adafruit/Adafruit-DC-Stepper-Motor-FeatherWing-PCB/Adafruit DC+Stepper Wing.brd

## EAGLE design Adafruit DC+Stepper Wing.brd (2016-03-01)

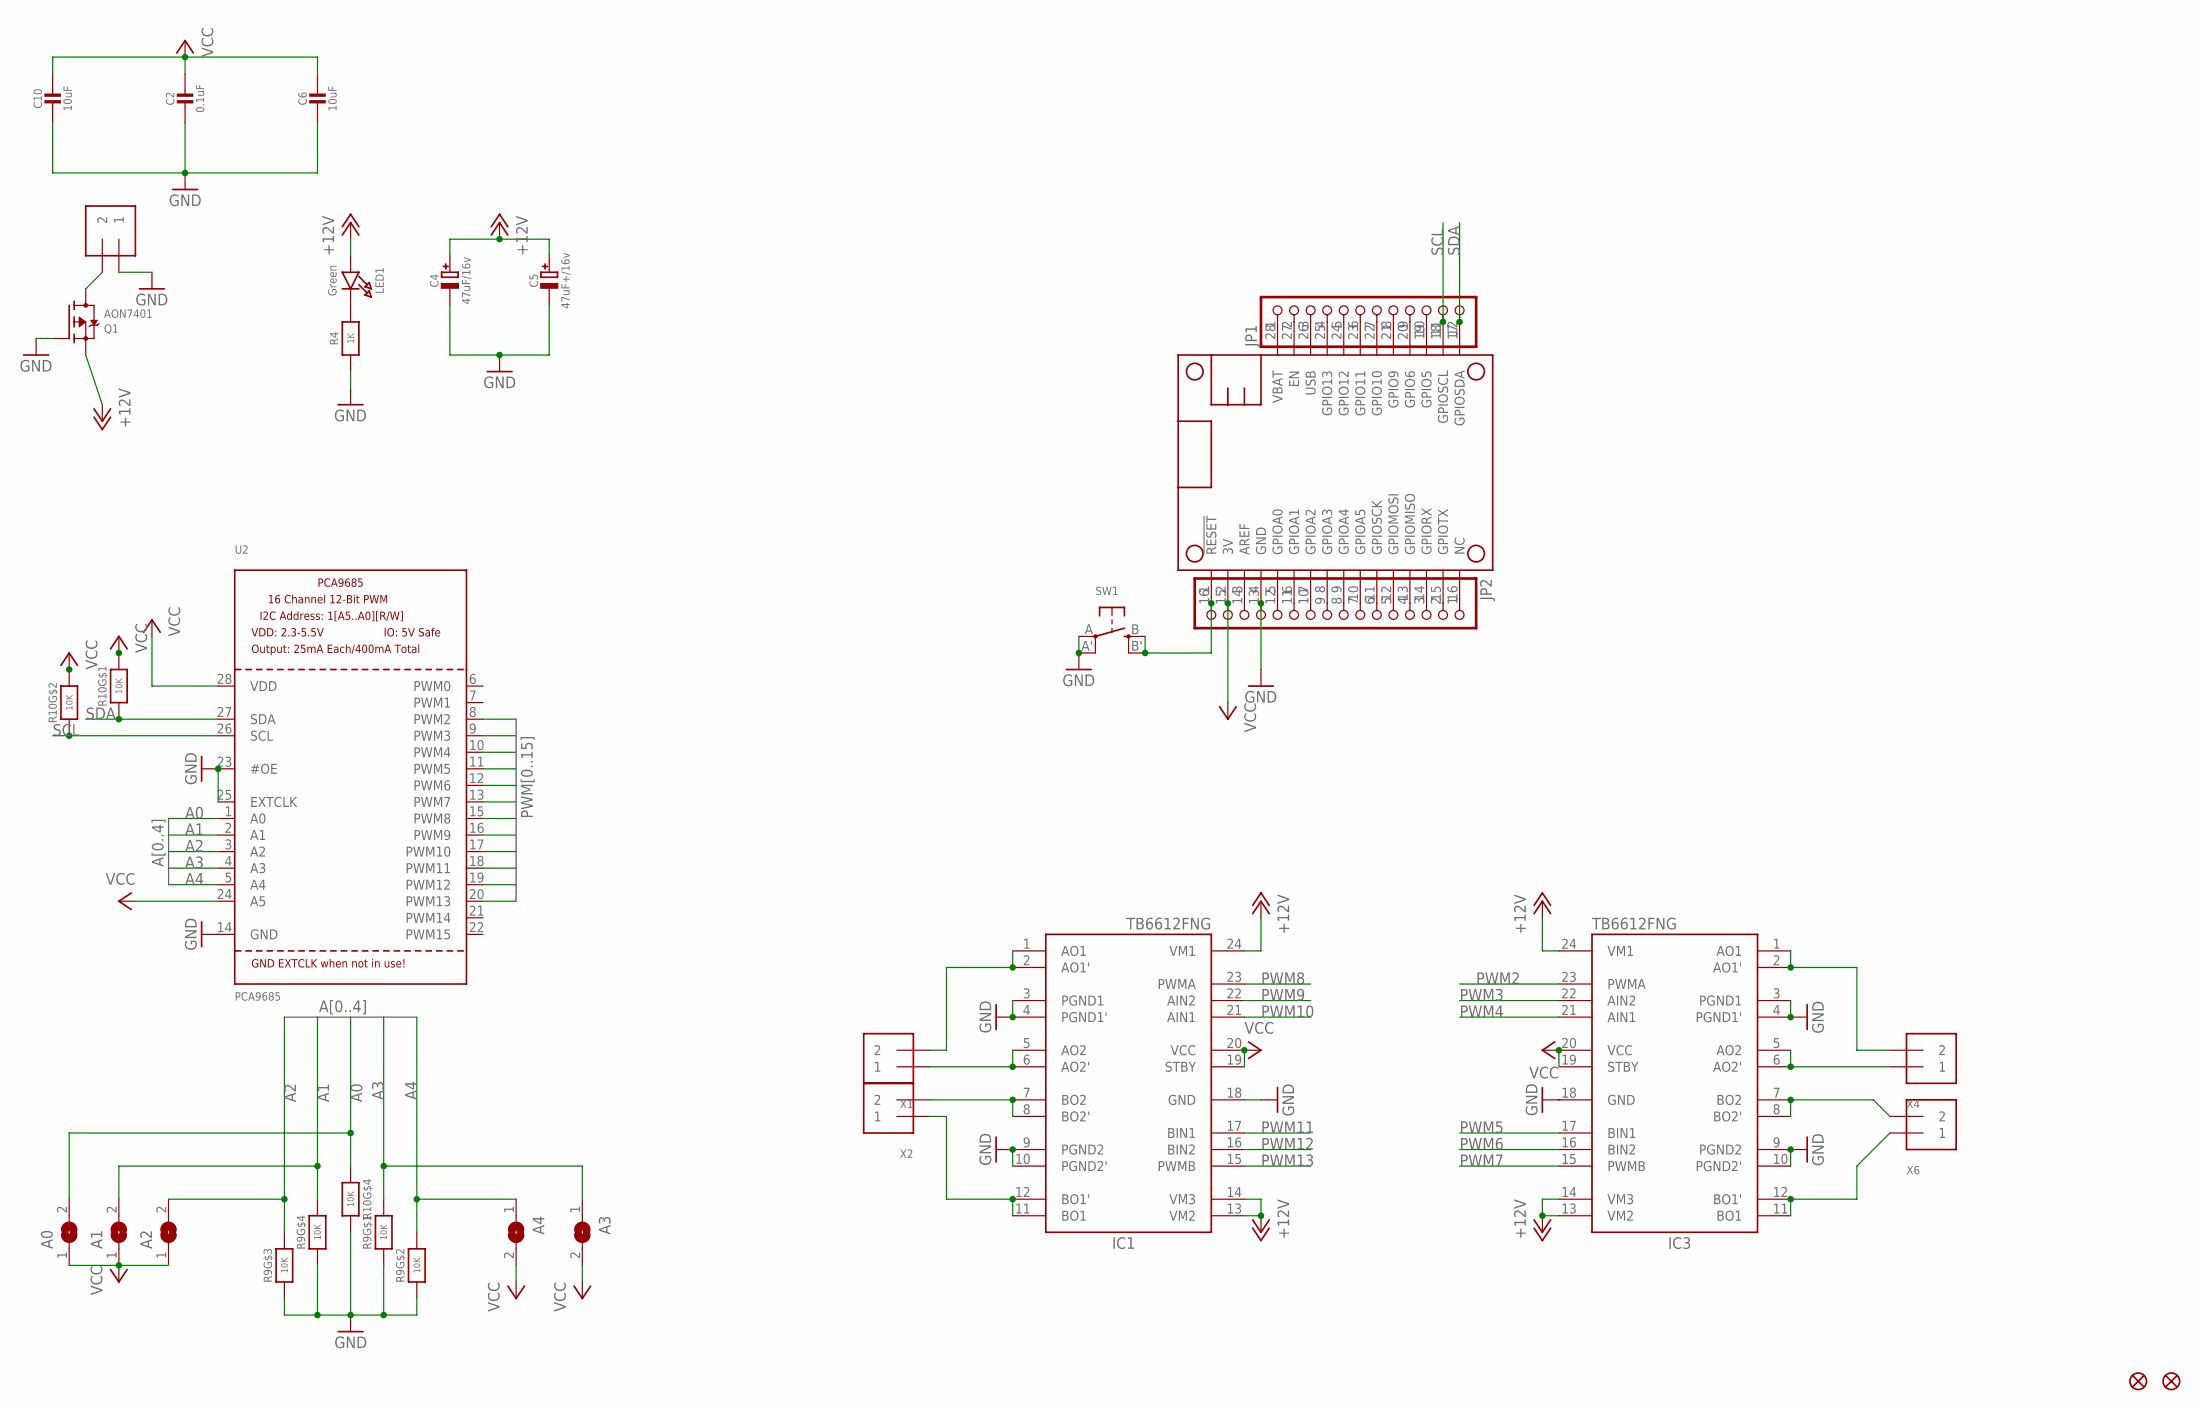
[picture p2: schematic Adafruit DC+Stepper Wing.sch]

Parts:
A0, A1, A2, A3, A4: SOLDERJUMPERREFLOW_NOPASTE; SOLDERJUMPER_REFLOW_NOPASTE
C2: 0.1uF; 0805-NO
C4: 47uF/16v; PANASONIC_C
C5: 47uF+/16v; PANASONIC_C
C6, C10: 10uF; 0805-NO
IC1, IC3: TB6612FNG; SSOP24
JP1: HEADER-1X12; 1X12_ROUND
JP2: HEADER-1X16ROUND; 1X16_ROUND
LED1: Green; CHIPLED_0805_NOOUTLINE
MPOWER: 1X2-3.5MM
MS1: FEATHERWING
Q1: AON7401; POWERDI3333
R4: 1K; 0805-NO
R9, R10: 10K; RESPACK_4X0603
SW1: SWITCH_TACT_SMT4.6X2.8; BTN_KMR2_4.6X2.8
U2: PCA9685; TSSOP28
U$3, U$4: FIDUCIAL""; FIDUCIAL_1MM
X1, X2, X4, X6: TERMBLOCK_1X2; TERMBLOCK_1X2-3.5MM

Connections:
+12V: C4.+, C5.+, IC1.13 (VM2), IC1.14 (VM3), IC1.24 (VM1), IC3.13 (VM2), IC3.14 (VM3), IC3.24 (VM1), LED1.A, Q1.1 (S), Q1.2 (S), Q1.3 (S)
A0: A0.2, R10.4 (1), U2.1 (A0)
A1: A1.2, R9.5 (2), U2.2 (A1)
A2: A2.2, R9.6 (2), U2.3 (A2)
A3: A3.1, R9.8 (2), U2.4 (A3)
A4: A4.1, R9.7 (2), U2.5 (A4)
GND: C2.2, C4.-, C5.-, C6.2, C10.2, IC1.3 (PGND1), IC1.4 (PGND1'), IC1.9 (PGND2), IC1.10 (PGND2'), IC1.18 (GND), IC3.3 (PGND1), IC3.4 (PGND1'), IC3.9 (PGND2), IC3.10 (PGND2'), IC3.18 (GND), JP2.13, MPOWER.1, MS1.4 (GND), Q1.4 (G), R4.1, R9.1, R9.2 (1), R9.3 (1), R9.4 (1), R10.5 (2), SW1.A, SW1.A' (P1), U2.14 (GND), U2.23 (#OE), U2.25 (EXTCLK)
unnamed: JP1.2, MS1.27 (EN)
unnamed: JP1.4, MS1.25 (GPIO13)
unnamed: MPOWER.2, Q1.5678 (D)
unnamed: IC1.1 (AO1), IC1.2 (AO1'), X1.2
unnamed: JP1.5, MS1.24 (GPIO12)
unnamed: IC1.5 (AO2), IC1.6 (AO2'), X1.1
unnamed: IC1.7 (BO2), IC1.8 (BO2'), X2.2
unnamed: JP1.6, MS1.23 (GPIO11)
unnamed: IC1.11 (BO1), IC1.12 (BO1'), X2.1
unnamed: JP1.7, MS1.22 (GPIO10)
unnamed: JP1.8, MS1.21 (GPIO9)
unnamed: IC3.1 (AO1), IC3.2 (AO1'), X4.2
unnamed: JP1.9, MS1.20 (GPIO6)
unnamed: IC3.5 (AO2), IC3.6 (AO2'), X4.1
unnamed: IC3.7 (BO2), IC3.8 (BO2'), X6.2
unnamed: JP1.10, MS1.19 (GPIO5)
unnamed: IC3.11 (BO1), IC3.12 (BO1'), X6.1
unnamed: JP2.1, MS1.16 (NC)
unnamed: JP2.2, MS1.15 (GPIOTX)
unnamed: JP2.3, MS1.14 (GPIORX)
unnamed: JP2.4, MS1.13 (GPIOMISO)
unnamed: JP2.5, MS1.12 (GPIOMOSI)
unnamed: JP2.6, MS1.11 (GPIOSCK)
unnamed: JP2.7, MS1.10 (GPIOA5)
unnamed: JP2.8, MS1.9 (GPIOA4)
unnamed: JP2.9, MS1.8 (GPIOA3)
unnamed: JP2.10, MS1.7 (GPIOA2)
unnamed: JP2.11, MS1.6 (GPIOA1)
unnamed: JP2.12, MS1.5 (GPIOA0)
unnamed: JP2.14, MS1.3 (AREF)
unnamed: JP2.16, MS1.1 (!RESET), SW1.B (S), SW1.B' (S1)
unnamed: LED1.C, R4.2
PWM2: IC3.23 (PWMA), U2.8 (PWM2)
PWM3: IC3.22 (AIN2), U2.9 (PWM3)
PWM4: IC3.21 (AIN1), U2.10 (PWM4)
PWM5: IC3.17 (BIN1), U2.11 (PWM5)
PWM6: IC3.16 (BIN2), U2.12 (PWM6)
PWM7: IC3.15 (PWMB), U2.13 (PWM7)
PWM8: IC1.23 (PWMA), U2.15 (PWM8)
PWM9: IC1.22 (AIN2), U2.16 (PWM9)
PWM10: IC1.21 (AIN1), U2.17 (PWM10)
PWM11: IC1.17 (BIN1), U2.18 (PWM11)
PWM12: IC1.16 (BIN2), U2.19 (PWM12)
PWM13: IC1.15 (PWMB), U2.20 (PWM13)
SCL: JP1.11, MS1.18 (GPIOSCL), R10.2 (1), U2.26 (SCL)
SDA: JP1.12, MS1.17 (GPIOSDA), R10.1, U2.27 (SDA)
USB: JP1.3, MS1.26 (USB)
VBAT: JP1.1, MS1.28 (VBAT)
VCC: A0.1, A1.1, A2.1, A3.2, A4.2, C2.1, C6.1, C10.1, IC1.19 (STBY), IC1.20 (VCC), IC3.19 (STBY), IC3.20 (VCC), JP2.15, MS1.2 (3V), R10.7 (2), R10.8 (2), U2.24 (A5), U2.28 (VDD)

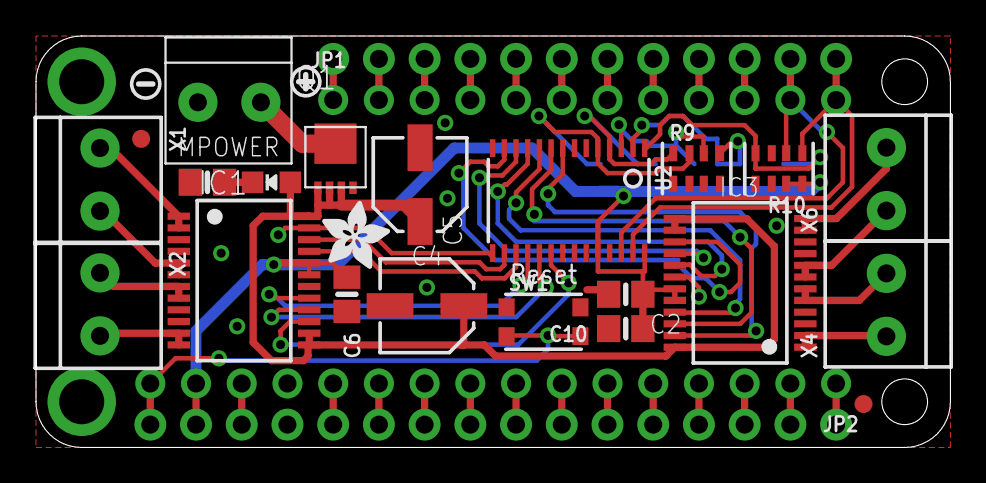
[picture p3: board Adafruit DC+Stepper Wing.brd from above]

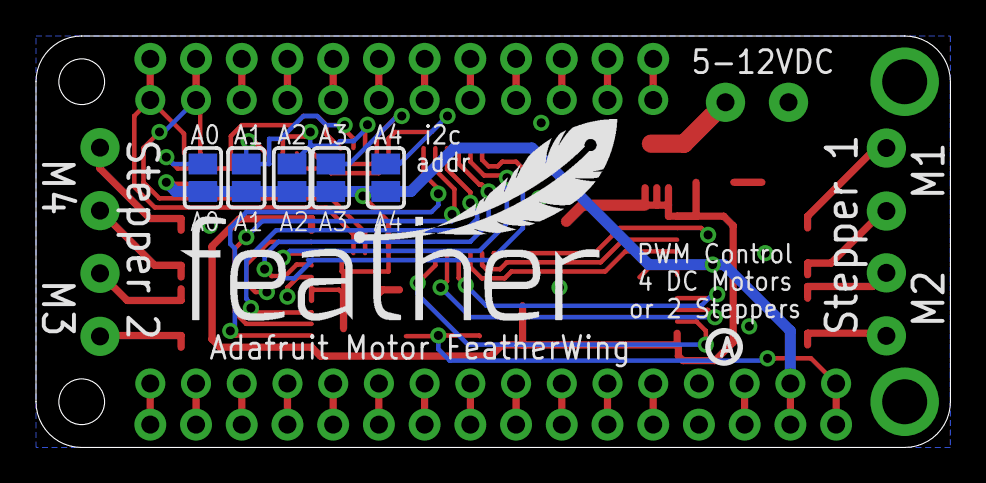
[picture p4: board Adafruit DC+Stepper Wing.brd from below]

Board: 2 copper layers, 50.8 x 22.9 mm, 34 parts (7 on the bottom side), 56 nets.

Other parts of the board:
U$1: SYMBOL_PLUS
U$2: SYMBOL_MINUS
U$5: ADAFRUIT_3.5MM
U$6: FEATHERLOGO
U$8: PCBFEAT-REV-040
